AndreyPodlesni/UsbKeyboardSniffer/USB_Device_Final/Core/Src/main.c

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
/* Includes ------------------------------------------------------------------*/
#include "main.h"
#include "usart.h"
#include "usb_device.h"
#include "gpio.h"

/* USER CODE BEGIN Includes */
#include <stdio.h>
#include "usbd_hid.h"
#include <stdint.h>
/* USER CODE END Includes */

/* USER CODE BEGIN PTD */
typedef struct
{
  uint8_t state;
  uint8_t lctrl;
  uint8_t lshift;
  uint8_t lalt;
  uint8_t lgui;
  uint8_t rctrl;
  uint8_t rshift;
  uint8_t ralt;
  uint8_t rgui;
  uint8_t keys[6];
}
HID_KEYBD_Info_TypeDef;

typedef struct
{
	uint8_t MODIFIER;
	uint8_t RESERVED;
	uint8_t KEYCODE1;
	uint8_t KEYCODE2;
	uint8_t KEYCODE3;
	uint8_t KEYCODE4;
	uint8_t KEYCODE5;
	uint8_t KEYCODE6;
} keyboardHID;

/* USER CODE END PTD */


/* USER CODE BEGIN PV */
HID_KEYBD_Info_TypeDef keyboardInfo = {0,0,0,0,0,0,0,0,0,0};
keyboardHID keyboardhid = {0,0,0,0,0,0,0,0};
uint8_t uartBuffer[sizeof(HID_KEYBD_Info_TypeDef)];
uint8_t KeyInjectionUartBuffer[sizeof(keyboardHID)];
keyboardHID KeyInjectionHID;

/* USER CODE END PV */

void SystemClock_Config(void);
/* USER CODE BEGIN PFP */
void ConvertToKeyboardHID(const HID_KEYBD_Info_TypeDef *hostData, keyboardHID *deviceData);
void ReadUARTtoHIDInfo(UART_HandleTypeDef *huart);
/* USER CODE END PFP */

/* USER CODE BEGIN 0 */
extern USBD_HandleTypeDef hUsbDeviceFS;
/* USER CODE END 0 */

/**
  * @brief  The application entry point.
  * @retval int
  */
int main(void)
{
  /* MCU Configuration--------------------------------------------------------*/

  /* Reset of all peripherals, Initializes the Flash interface and the Systick. */
  HAL_Init();

  /* Configure the system clock */
  SystemClock_Config();

  /* Initialize all configured peripherals */
  MX_GPIO_Init();
  MX_USB_DEVICE_Init();
  MX_USART2_UART_Init();
  MX_USART3_UART_Init();
  /* USER CODE BEGIN 2 */
  HAL_UART_Receive_IT(&huart3, uartBuffer, sizeof(uartBuffer));
  HAL_UART_Receive_IT(&huart2, KeyInjectionUartBuffer, sizeof(KeyInjectionUartBuffer));
  printf("Started");
  /* USER CODE END 2 */

  /* Infinite loop */
  /* USER CODE BEGIN WHILE */
  while (1)
  {
    /* USER CODE END WHILE */

    /* USER CODE BEGIN 3 */

  }
  /* USER CODE END 3 */
}

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
/* USER CODE BEGIN 4 */

void ReadUARTtoHIDInfo(UART_HandleTypeDef *huart) {
   // HAL_UART_Receive(huart, uartBuffer, sizeof(uartBuffer), HAL_MAX_DELAY);
    memcpy(&keyboardInfo, uartBuffer, sizeof(HID_KEYBD_Info_TypeDef));
    // Convert the data
    ConvertToKeyboardHID(&keyboardInfo, &keyboardhid);
    // Send the converted data
    USBD_HID_SendReport(&hUsbDeviceFS, &keyboardhid, sizeof (keyboardhid));
   char massage[] = "Key recived";
   HAL_UART_Transmit(&huart3, massage, sizeof(massage), HAL_MAX_DELAY);

    //HAL_UART_Transmit(&huart3, uartBuffer, sizeof(uartBuffer), HAL_MAX_DELAY);
}




void ConvertToKeyboardHID(const HID_KEYBD_Info_TypeDef *hostData, keyboardHID *deviceData) {
    // Clear the deviceData struct
    *deviceData = (keyboardHID){0};

    // Set the MODIFIER byte
    deviceData->MODIFIER = (hostData->lctrl ? 0x01 : 0) |
                           (hostData->lshift ? 0x02 : 0) |
                           (hostData->lalt ? 0x04 : 0) |
                           (hostData->lgui ? 0x08 : 0) |
                           (hostData->rctrl ? 0x10 : 0) |
                           (hostData->rshift ? 0x20 : 0) |
                           (hostData->ralt ? 0x40 : 0) |
                           (hostData->rgui ? 0x80 : 0);

    // RESERVED byte is typically set to 0
    deviceData->RESERVED = 0;

    // Copy the keys
    if (hostData->keys[0]) deviceData->KEYCODE1 = hostData->keys[0];
    if (hostData->keys[1]) deviceData->KEYCODE2 = hostData->keys[1];
    if (hostData->keys[2]) deviceData->KEYCODE3 = hostData->keys[2];
    if (hostData->keys[3]) deviceData->KEYCODE4 = hostData->keys[3];
    if (hostData->keys[4]) deviceData->KEYCODE5 = hostData->keys[4];
    if (hostData->keys[5]) deviceData->KEYCODE6 = hostData->keys[5];
}


//
void HAL_UART_RxCpltCallback(UART_HandleTypeDef *huart)
{
    // Check if the callback comes from UART3
    if(huart->Instance == USART3)
    {
        memcpy(&keyboardInfo, uartBuffer, sizeof(HID_KEYBD_Info_TypeDef));
        ConvertToKeyboardHID(&keyboardInfo, &keyboardhid);
        USBD_HID_SendReport(&hUsbDeviceFS, &keyboardhid, sizeof(keyboardhid));
        HAL_UART_Transmit(&huart3, uartBuffer, sizeof(uartBuffer), HAL_MAX_DELAY);
        HAL_UART_Receive_IT(&huart3, uartBuffer, sizeof(uartBuffer));
    }
    if(huart->Instance == USART2)
    {
        memcpy(&KeyInjectionHID, KeyInjectionUartBuffer, sizeof(keyboardHID));
    	USBD_HID_SendReport(&hUsbDeviceFS, &KeyInjectionHID, sizeof (uartBuffer));
    	HAL_UART_Receive_IT(&huart2, KeyInjectionUartBuffer, sizeof(KeyInjectionUartBuffer));
    }

}









/* USER CODE END 4 */
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
