AndreyPodlesni/UsbKeyboardSniffer/USB_HOST_Final/USB_HOST_Final.ioc

Mcu.UserName=STM32F401CCUx
PA10.Signal=USART1_RX
PA11.Signal=USB_OTG_FS_DM
PA12.Signal=USB_OTG_FS_DP
PA2.Signal=USART2_TX
PA3.Signal=USART2_RX
PA9.Signal=USART1_TX
